microbug/soldering-station/README.md

# Soldering Station (Richard's Version)
A JBC-compatible open-source soldering station. Built for T245 tips.

## Hardware
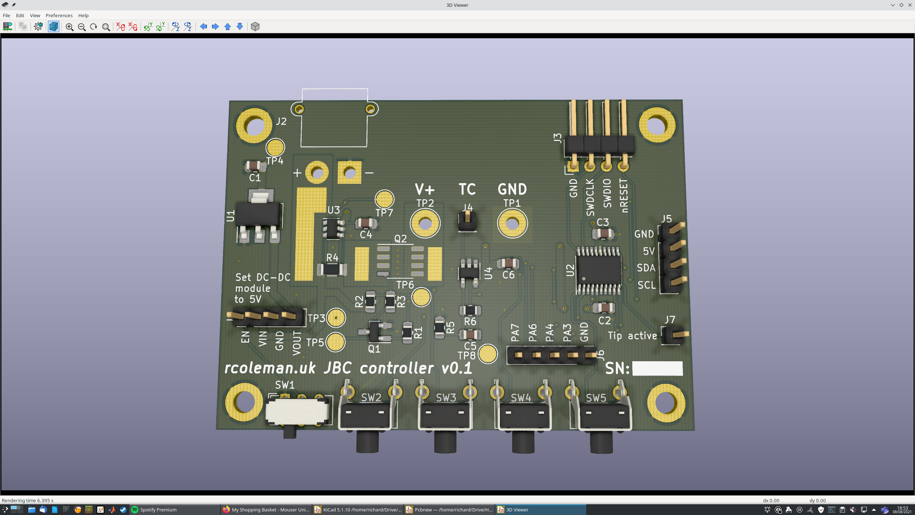
[picture p1: Hardware/Render v0.1.png]
Render of the PCB


## Firmware
An STM32CubeIDE project targetting an STM32L011F4Px.
