microbug/soldering-station/CAD/Face plate test v2.FCStd

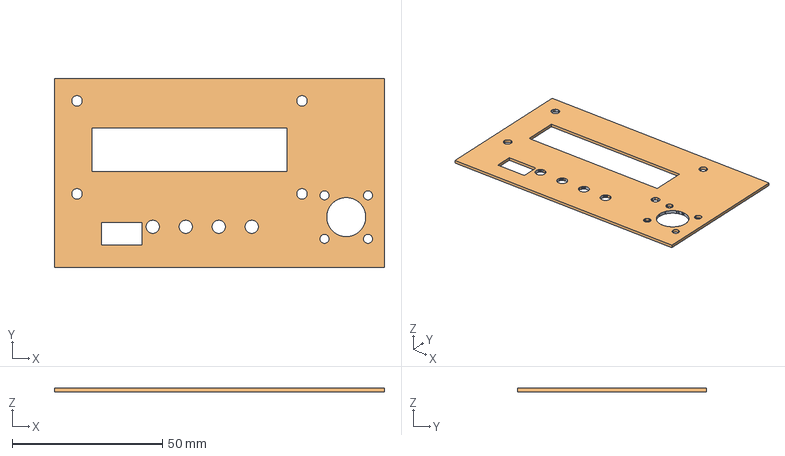
[picture p2: CAD file, 2024-03-07]
CAD/Face plate test v2.FCStd
110.0 x 63.1 x 1.20 mm
Body (Meshed)
