microbug/soldering-station/CAD/Face plate v1.FCStd

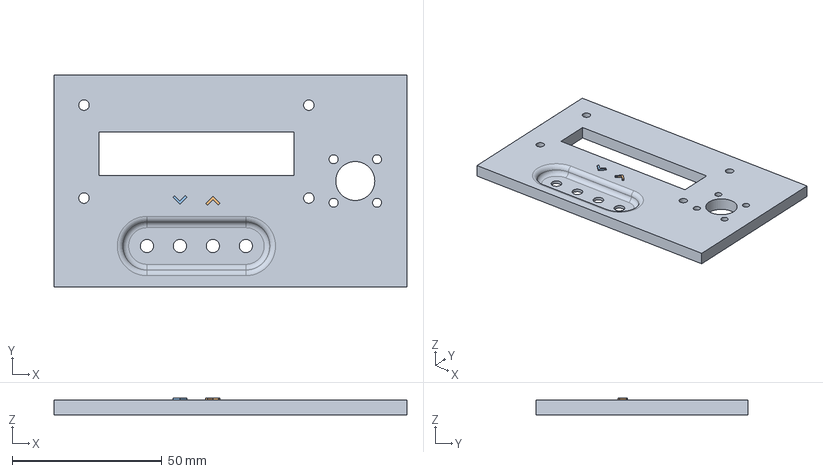
[picture p3: CAD file, 2024-03-07]
CAD/Face plate v1.FCStd
117.8 x 70.6 x 5.60 mm
up label
down extrusion
