microbug/soldering-station/CAD/cap-test-v2.stl

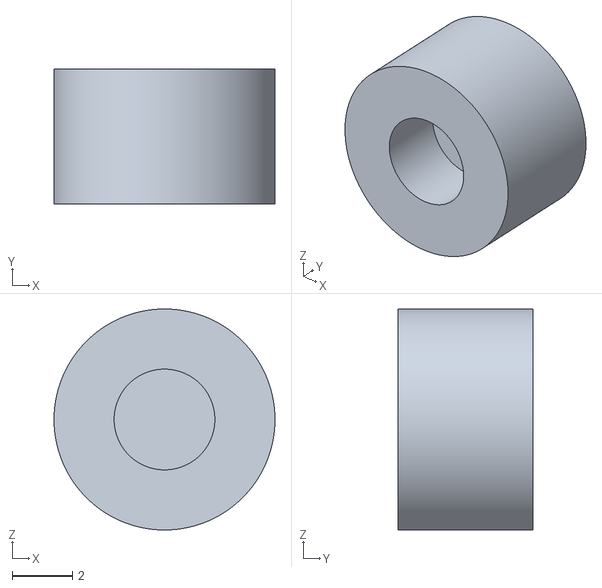
[picture p4: CAD file, 2024-03-01]
CAD/cap-test-v2.stl
7.35 x 4.50 x 7.35
