microbug/soldering-station/CAD/Button Cap Test.FCStd

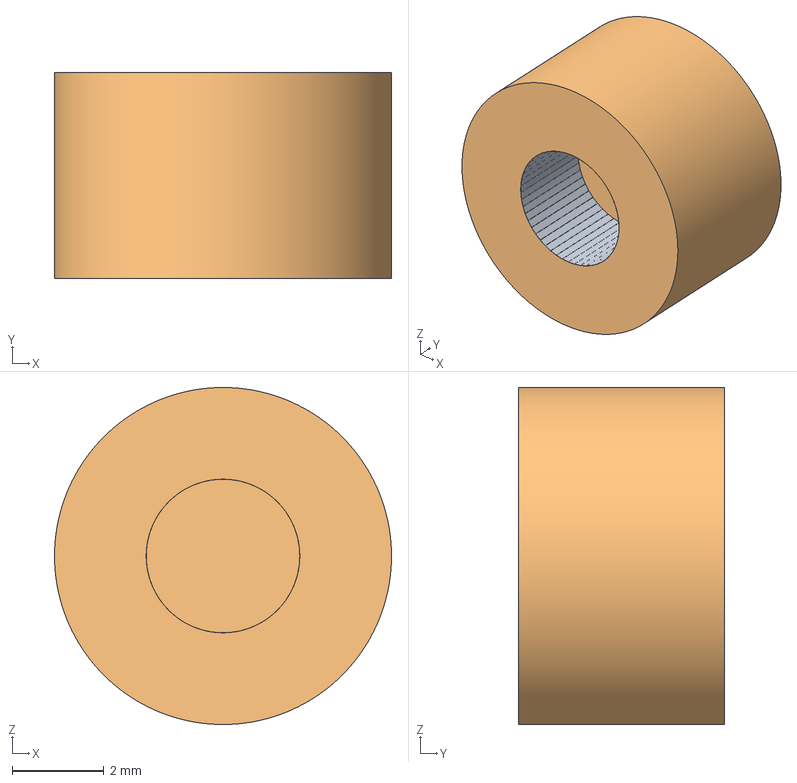
[picture p5: CAD file, 2024-03-01]
CAD/Button Cap Test.FCStd
7.35 x 4.50 x 7.35 mm
Body (Meshed)
