microbug/soldering-station/CAD/Face plate test v1.FCStd

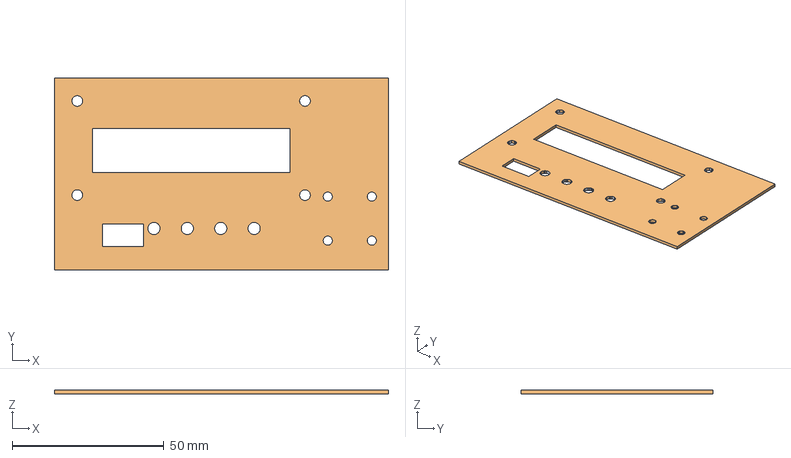
[picture p6: CAD file, 2024-03-07, an earlier design]
CAD/Face plate test v1.FCStd
110.0 x 63.1 x 1.20 mm
Body (Meshed)
