microbug/soldering-station/CAD/cap-test-v1.stl

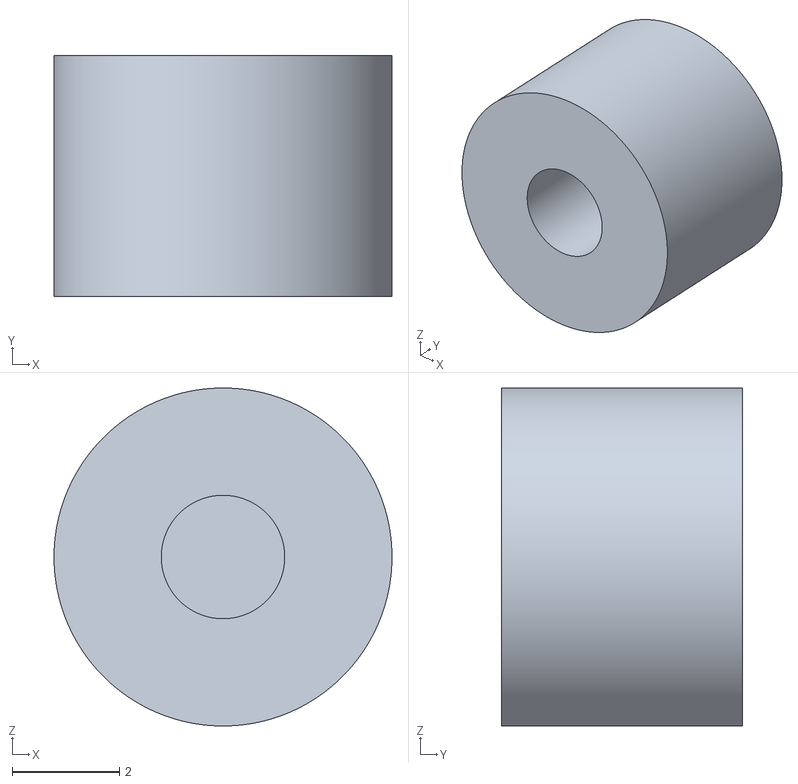
[picture p7: CAD file, 2024-03-01, an earlier design]
CAD/cap-test-v1.stl
6.30 x 4.50 x 6.30
