microbug/soldering-station/(list of files, cad)

Other CAD files:
CAD/Face plate test v1.stl
CAD/Face plate test v2.stl
