microbug/soldering-station/Hardware/JBC controller.pdf

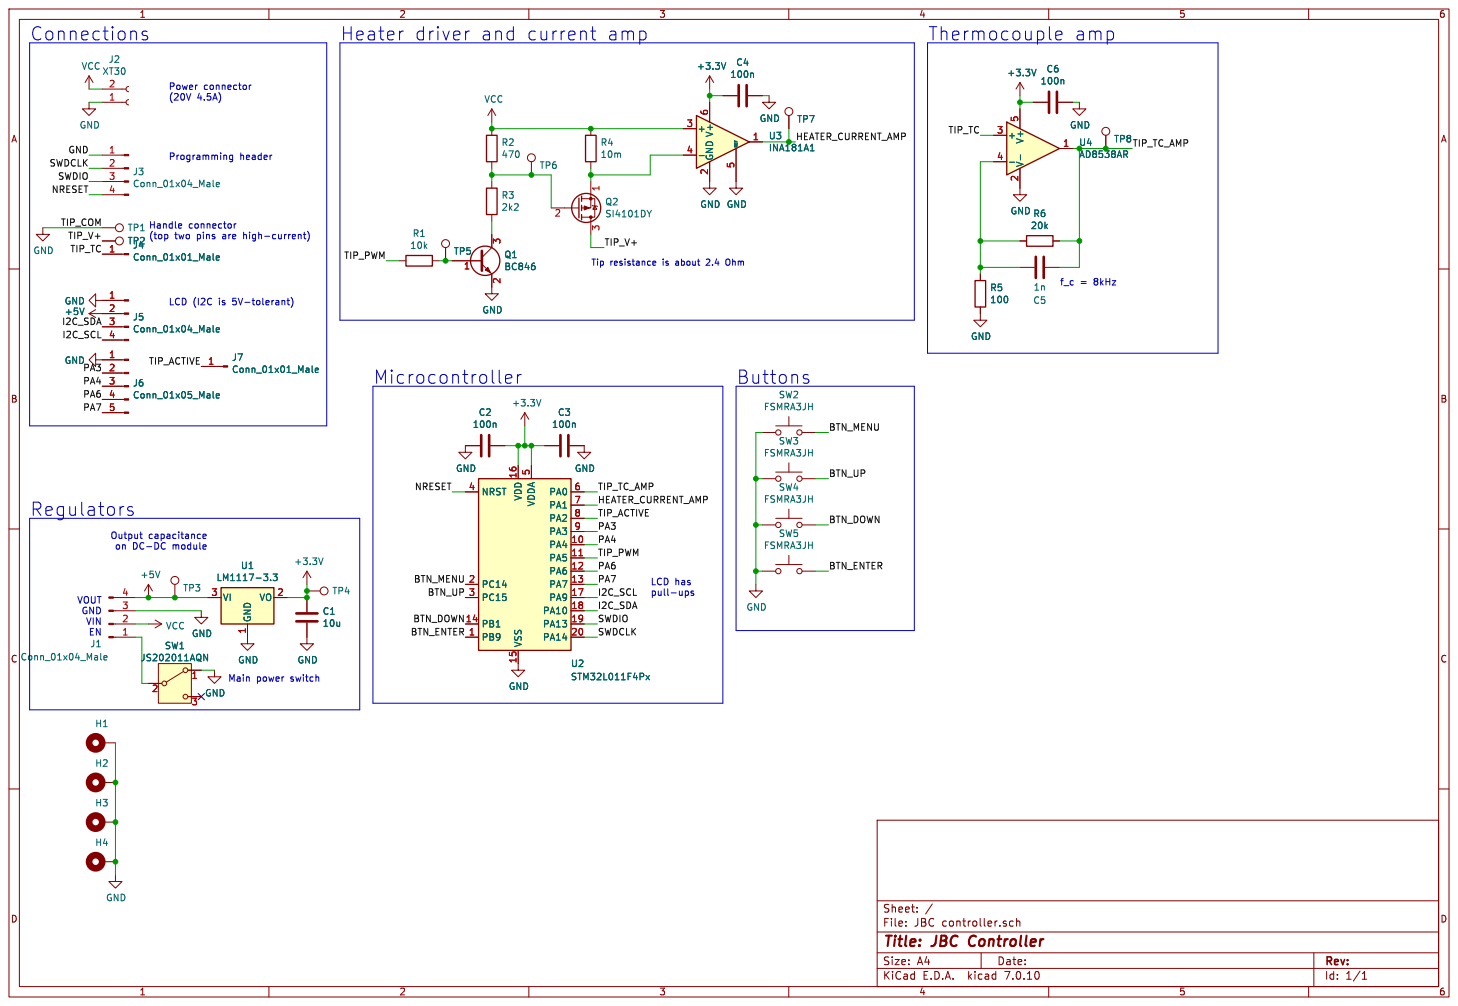
[picture p8: page 1]

(top two pins are high-current) LCD (I2C is 5V-tolerant)

f_c = 8kHz LCD has pull-ups

Id: 1/1 Title: JBC Controller File: JBC controller.sch Sheet: /
