microbug/soldering-station/Hardware/JBC controller.kicad_pcb

## KiCad design Hardware/JBC controller.kicad_pcb (2024-03-01)

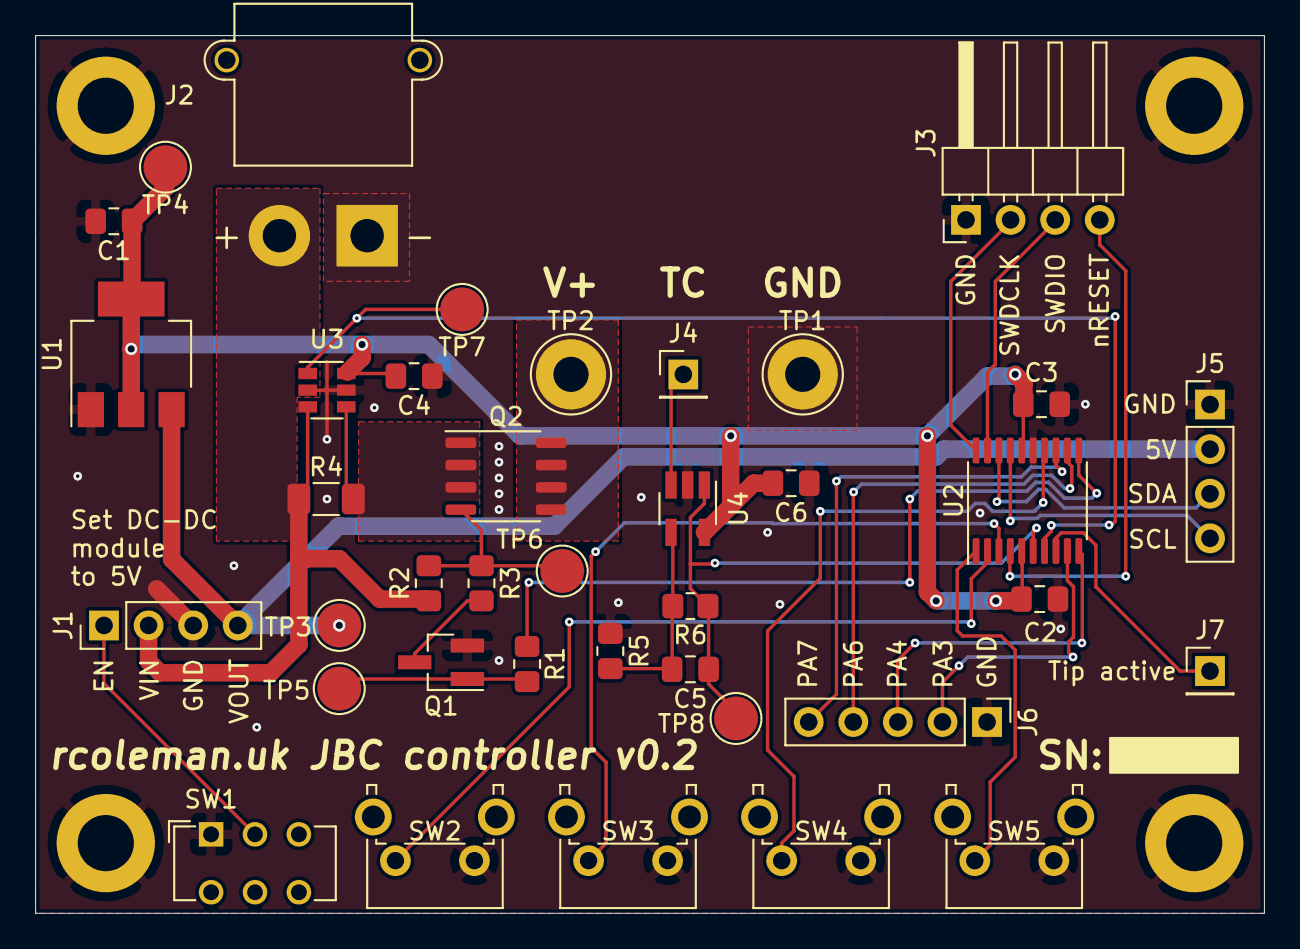
[picture p9: board JBC controller.kicad_pcb from above]

Board: 2 copper layers, 70.0 x 50.0 mm, 42 parts (0 on the bottom side), 29 nets.

Parts:
C1: 10u; C_0805_2012Metric_Pad1.18x1.45mm_HandSolder
C2, C3, C4, C6: 100n; C_0805_2012Metric_Pad1.18x1.45mm_HandSolder
C5: 1n; C_0805_2012Metric_Pad1.18x1.45mm_HandSolder
H1, H2, H3, H4: MountingHole_Pad; MountingHole_3.2mm_M3_DIN965_Pad
J1, J5: Conn_01x04_Male; PinHeader_1x04_P2.54mm_Vertical
J2: XT30; AMASS_XT30PW-M_1x02_P2.50mm_Horizontal
J3: Conn_01x04_Male; PinHeader_1x04_P2.54mm_Horizontal
J4, J7: Conn_01x01_Male; PinHeader_1x01_P2.54mm_Vertical
J6: Conn_01x05_Male; PinHeader_1x05_P2.54mm_Vertical
Q1: BC846; SOT-23_Handsoldering
Q2: SI4101DY
R1: 10k; R_0805_2012Metric_Pad1.20x1.40mm_HandSolder
R2: 470; R_0805_2012Metric_Pad1.20x1.40mm_HandSolder
R3: 2k2; R_0805_2012Metric_Pad1.20x1.40mm_HandSolder
R4: 10m; R_1206_3216Metric_Pad1.30x1.75mm_HandSolder
R5: 100; R_0805_2012Metric_Pad1.20x1.40mm_HandSolder
R6: 20k; R_0805_2012Metric_Pad1.20x1.40mm_HandSolder
SW1: JS202011AQN; SW_CuK_JS202011AQN_DPDT_Angled
SW2, SW3, SW4, SW5: FSMRA3JH; SW_Tactile_SPST_Angled_PTS645Vx58-2LFS
TP1, TP2: TestPoint; TestPoint_Plated_Hole_D3.0mm
TP3, TP4, TP5, TP6, TP7, TP8: TestPoint; TestPoint_Pad_D2.5mm
U1: LM1117-3.3; SOT-223-3_TabPin2
U2: STM32L011F4Px; TSSOP-20_4.4x6.5mm_P0.65mm
U3: INA181A1; SOT-23-6
U4: AD8538AR; SOT-23-5_HandSoldering

Connections:
+3V3: C1.1, C2.1, C3.2, C4.2, C6.2, TP4.1, U1.2, U2.5, U2.16, U3.6, U4.5
+5V: J1.4, J5.2, TP3.1, U1.3
/BTN_DOWN: SW4.2, U2.14
/BTN_ENTER: SW5.2, U2.1
/BTN_MENU: SW2.2, U2.2
/BTN_UP: SW3.2, U2.3
/HEATER_CURRENT_AMP: TP7.1, U2.7, U3.1
/I2C_SCL: J5.4, U2.17
/I2C_SDA: J5.3, U2.18
/NRESET: J3.4, U2.4
/PA3: J6.2, U2.9
/PA4: J6.3, U2.10
/PA6: J6.4, U2.12
/PA7: J6.5, U2.13
/SWDCLK: J3.2, U2.20
/SWDIO: J3.3, U2.19
/TIP_ACTIVE: J7.1, U2.8
/TIP_PWM: R1.2, U2.11
/TIP_TC: J4.1, U4.3
/TIP_TC_AMP: C5.1, R6.1, TP8.1, U2.6, U4.1
/TIP_V+: Q2.3, TP2.1
GND: C1.2, C2.2, C3.1, C4.1, C6.1, H1.1, H2.1, H3.1, H4.1, J1.3, J2.1, J3.1, J5.1, J6.1, Q1.2, R5.1, SW1.1, SW2.1, SW3.1, SW4.1, SW5.1, TP1.1, U1.1, U2.15, U3.2, U3.5, U4.2
unnamed: C5.2, R5.2, R6.2, U4.4
unnamed: J1.1, SW1.2
unnamed: Q1.1, R1.1, TP5.1
unnamed: Q1.3, R3.2
unnamed: Q2.1, R4.2, U3.4
unnamed: Q2.2, R2.2, R3.1, TP6.1
VCC: J1.2, J2.2, R2.1, R4.1, U3.3
