microbug/soldering-station/Firmware/Core/Inc/main.h

#define BTN_ENTER_Pin LL_GPIO_PIN_9
#define BTN_ENTER_GPIO_Port GPIOB
#define BTN_ENTER_EXTI_IRQn EXTI4_15_IRQn
#define BTN_MENU_Pin LL_GPIO_PIN_14
#define BTN_MENU_GPIO_Port GPIOC
#define BTN_MENU_EXTI_IRQn EXTI4_15_IRQn
#define BTN_UP_Pin LL_GPIO_PIN_15
#define BTN_UP_GPIO_Port GPIOC
#define BTN_UP_EXTI_IRQn EXTI4_15_IRQn
#define TIP_TC_AMP_Pin LL_GPIO_PIN_0
#define TIP_TC_AMP_GPIO_Port GPIOA
#define HEATER_CURRENT_AMP_Pin LL_GPIO_PIN_1
#define HEATER_CURRENT_AMP_GPIO_Port GPIOA
#define TIP_ACTIVE_Pin LL_GPIO_PIN_2
#define TIP_ACTIVE_GPIO_Port GPIOA
#define OC_TEST_Pin LL_GPIO_PIN_3
#define OC_TEST_GPIO_Port GPIOA
#define TIP_PWM_Pin LL_GPIO_PIN_5
#define TIP_PWM_GPIO_Port GPIOA
#define BTN_DOWN_Pin LL_GPIO_PIN_1
#define BTN_DOWN_GPIO_Port GPIOB
#define BTN_DOWN_EXTI_IRQn EXTI0_1_IRQn
