microbug/soldering-station/(commit log)

2021-08-08 Initial commit (board v0.1)
    [JBC controller sim.kicad_pcb, JBC controller sim.sch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]
2024-03-01 Hardware v0.1
    [BOM v0.1.ods, JBC controller.csv, JBC controller.kicad_pcb, JBC controller.sch]
2024-03-01 Exclude KiCad and FreeCAD backups
2024-03-01 Button cap test
    [Button Cap Test.FCStd, cap-test-v1.stl, cap-test-v2.stl]
2024-03-01 Simulate hardware v0.1
    [JBC controller sim.sch]
2024-03-01 Another KiCad file
2024-03-02 Add no tool detection and ability to hold buttons
2024-03-03 Add LPUART reporting of tip temperature for PI(D) tuning
2024-03-05 Add tip inactive sleep and asymmetrical PID window
2024-03-05 LL ADC/DMA drivers to reduce code size
2024-03-07 Early CAD
    [Face plate test v1.FCStd, Face plate test v1.stl, Face plate test v2.FCStd, Face plate test v2.stl, Face plate v1.FCStd]
2024-03-07 Better error messages, make LCD driver non-reliant on ISRs
    [control_loop.c, control_loop.h, lcd_hd44780_i2c.c, lcd_hd44780_i2c.h, thermocouple.h, ui.c]
2025-08-29 Add EEPROM setpoint saving, increase display and button task frequency, update to latest CubeL0
